trinler007/AirQSensor/case/case 3.jpg

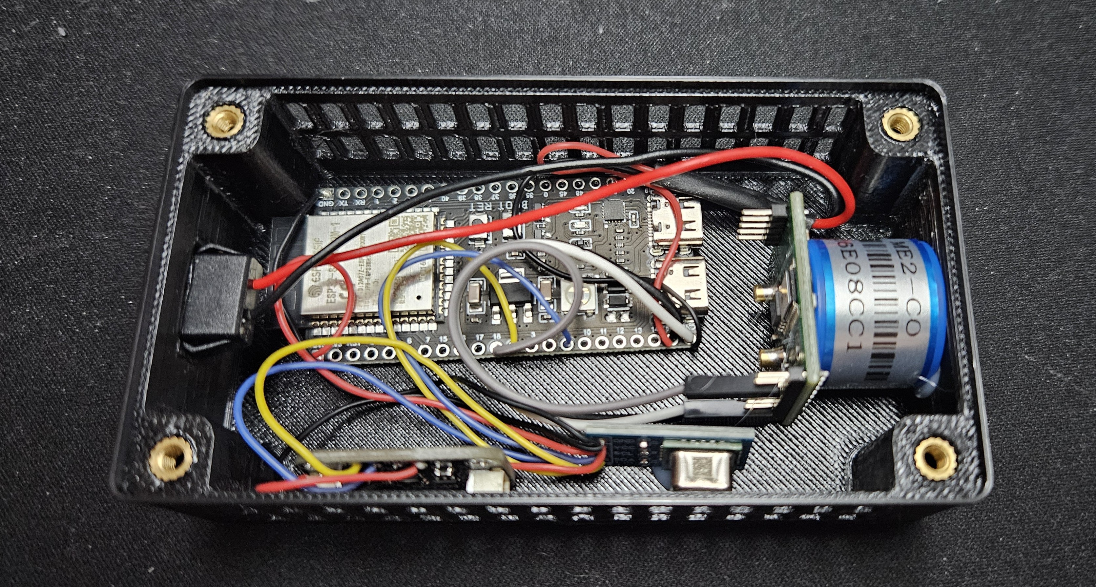
case/case 3.jpg
