trinler007/AirQSensor/case/case 1.jpg

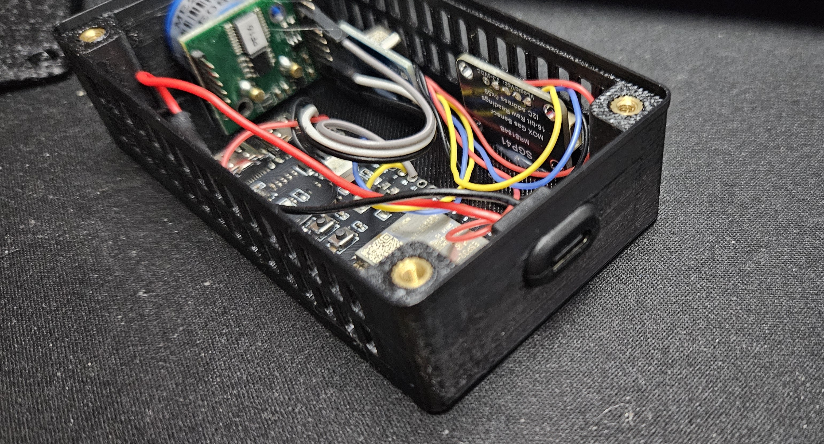
case/case 1.jpg
