trinler007/AirQSensor/case/case 2.jpg

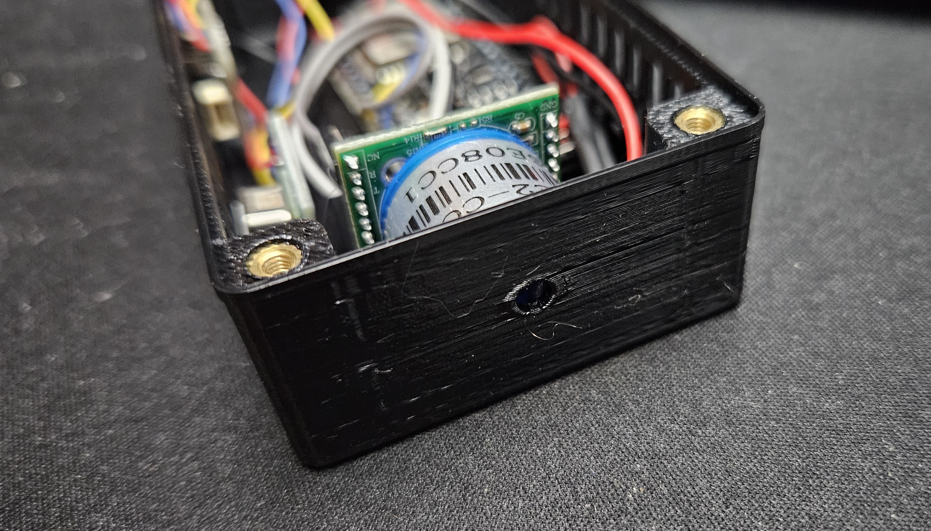
case/case 2.jpg
