trinler007/AirQSensor/case/case 4.jpg

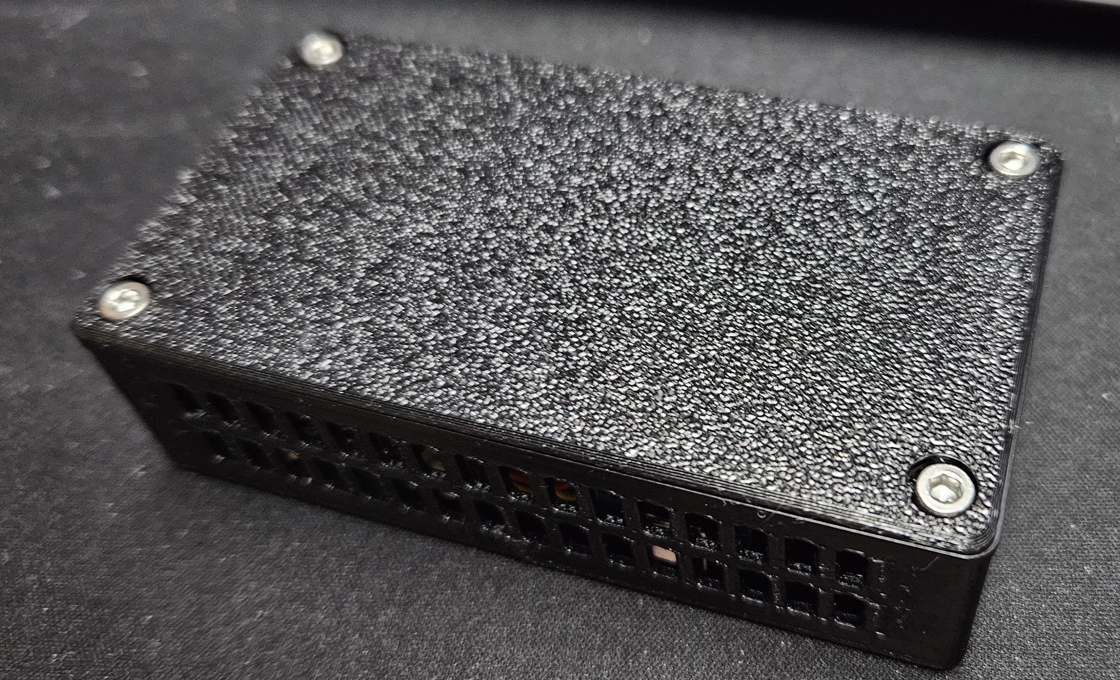
case/case 4.jpg
