trinler007/AirQSensor/case/AirQ case.3mf

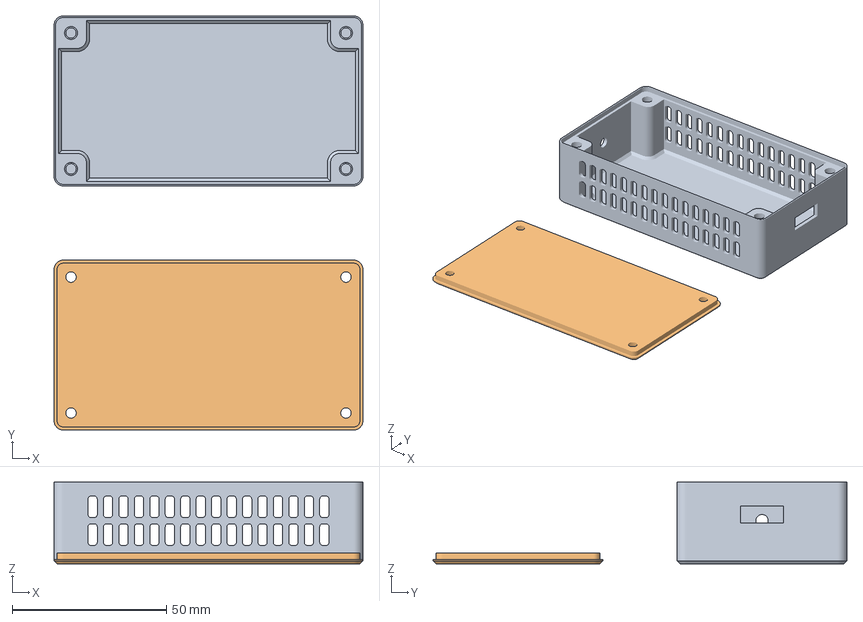
[picture p5: CAD file, 2026-07-22]
case/AirQ case.3mf
100.0 x 134.0 x 26.5 mm
Bottom
Lid
