trinler007/AirQSensor/(commit log)

2026-07-18 Initial ESPHome AirQ sensor project
2026-07-18 Optimize ZE07 UART pin assignment
2026-07-18 Separate device and security configuration
2026-07-18 Configure ESP32-S3 UART0 logger
2026-07-19 Add diagnostics and optional sensor packages
2026-07-19 Add controllable onboard RGB status LED
2026-07-22 Add CO and CO2 warning sensors
2026-07-22 Create 3d-printerfiles
2026-07-22 Rename AirQ Gehäuse.3mf to AirQ case.3mf
    [AirQ case.3mf]
2026-07-22 pictures of the case
    Case printed in PETG black
2026-10-21 Öffentliches Repo ohne Zugangsdaten, Tag-Pinning, messortspezifische Bewertung, CO-Grundlinie
    - Package und external_components ohne GitHub-Credentials, auf Tag v0.3.0 gepinnt
    - Schalter 'Temperatur in Bewertung'; im Fahrerhaus standardmäßig aus
    - Fahrerhaus: Startwert 'Grenzwert CO erhöht' 3 ppm
    - Diagnose 'CO Grundlinie 24h' und 'CO über Grundlinie'
    - SCD41-ASC per Substitution je Gerät steuerbar
    - Projektversion 0.3.0, README angepasst
    Claude-Session: https://claude.ai/code/session_01RNhQ5Aan1J5xDSLyEKavpP
